TLDSJPWORK/ESP32_CAN-FD_GWCombiBoard/hardware/production/README.md

# 製造データ

- [Gerber・ドリルデータ](ESP32_CAN-FD_GWCombiBoard.zip)
- [BOM](bom.csv)
- [部品情報](designators.csv)
- [部品配置](positions.csv)
- [ネットリスト](netlist.ipc)

再製造する場合は、使用する部品・実装内容に合わせてデータを確認してください。

BOMのU1はValue・Footprintが空欄です。部品実装を発注する場合は、使用するESP32開発ボードに合わせて補ってください。
