TLDSJPWORK/ESP32_CAN-FD_GWCombiBoard/hardware/production/bom.csv

Designator | Footprint | Quantity | Value | LCSC Part #
DB1 | DB9-TH_LD09P33E4GV00LF | 1 | XDDB-1809-0816 | C7498157
J1, J5 | PinSocket_1x19_P2.54mm_Vertical | 2 | Conn_01x19_Pin
J10, J9 | PinSocket_1x08_P2.54mm_Vertical | 2 | Conn_01x08_Socket
J2 | PinSocket_1x16_P2.54mm_Vertical | 1 | Conn_01x16_Pin
J3, J4 | PinSocket_1x03_P2.54mm_Vertical | 2 | Conn_01x03_Socket
J6 | JST_XH_B4B-XH-AM_1x04_P2.50mm_Vertical | 1 | Conn_01x04
J7 | PinSocket_1x03_P2.54mm_Vertical | 1 | Conn_01x03_Pin
J8 | TerminalBlock_RND_205-00012_1x02_P5.00mm_Horizontal | 1 | Screw_Terminal_01x02
U1 |  | 1
