TLDSJPWORK/ESP32_CAN-FD_GWCombiBoard/mechanical/ESP32_CAN-FD_GWCombiBoard-下筐体.stl

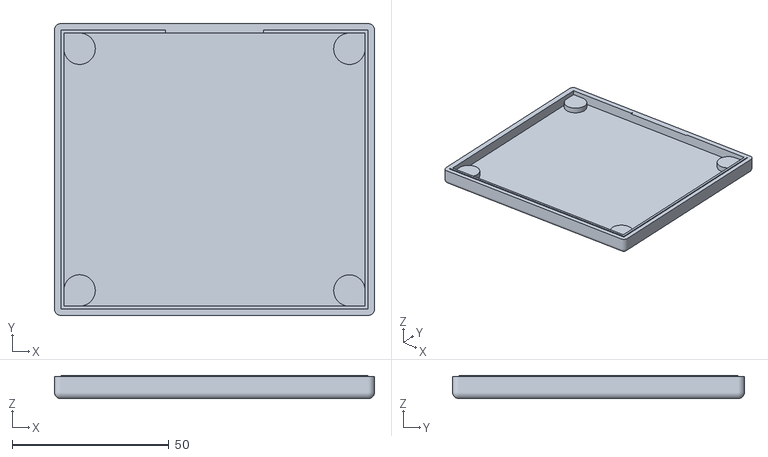
[picture p7: CAD file, 2026-10-12]
mechanical/ESP32_CAN-FD_GWCombiBoard-下筐体.stl
102.0 x 93.0 x 7.40
