TLDSJPWORK/ESP32_CAN-FD_GWCombiBoard/mechanical/ESP32_CAN-FD_GWCombiBoard.step

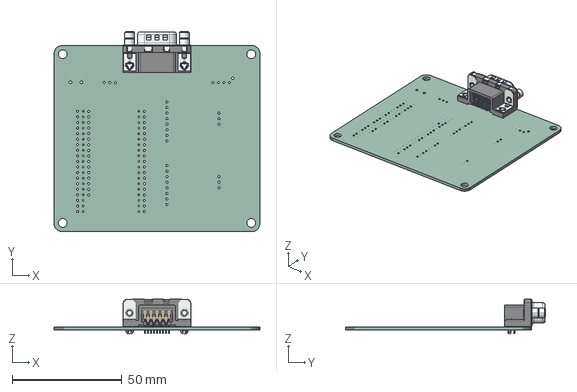
[picture p8: CAD file, 2026-10-12]
mechanical/ESP32_CAN-FD_GWCombiBoard.step
94.0 x 91.4 x 15.8 mm
DB9-TH_LD09P33E4GV00LF
ESP32_CAN-FD_GWCombiBoard_PCB
