TLDSJPWORK/ESP32_CAN-FD_GWCombiBoard/docs/schematic.pdf

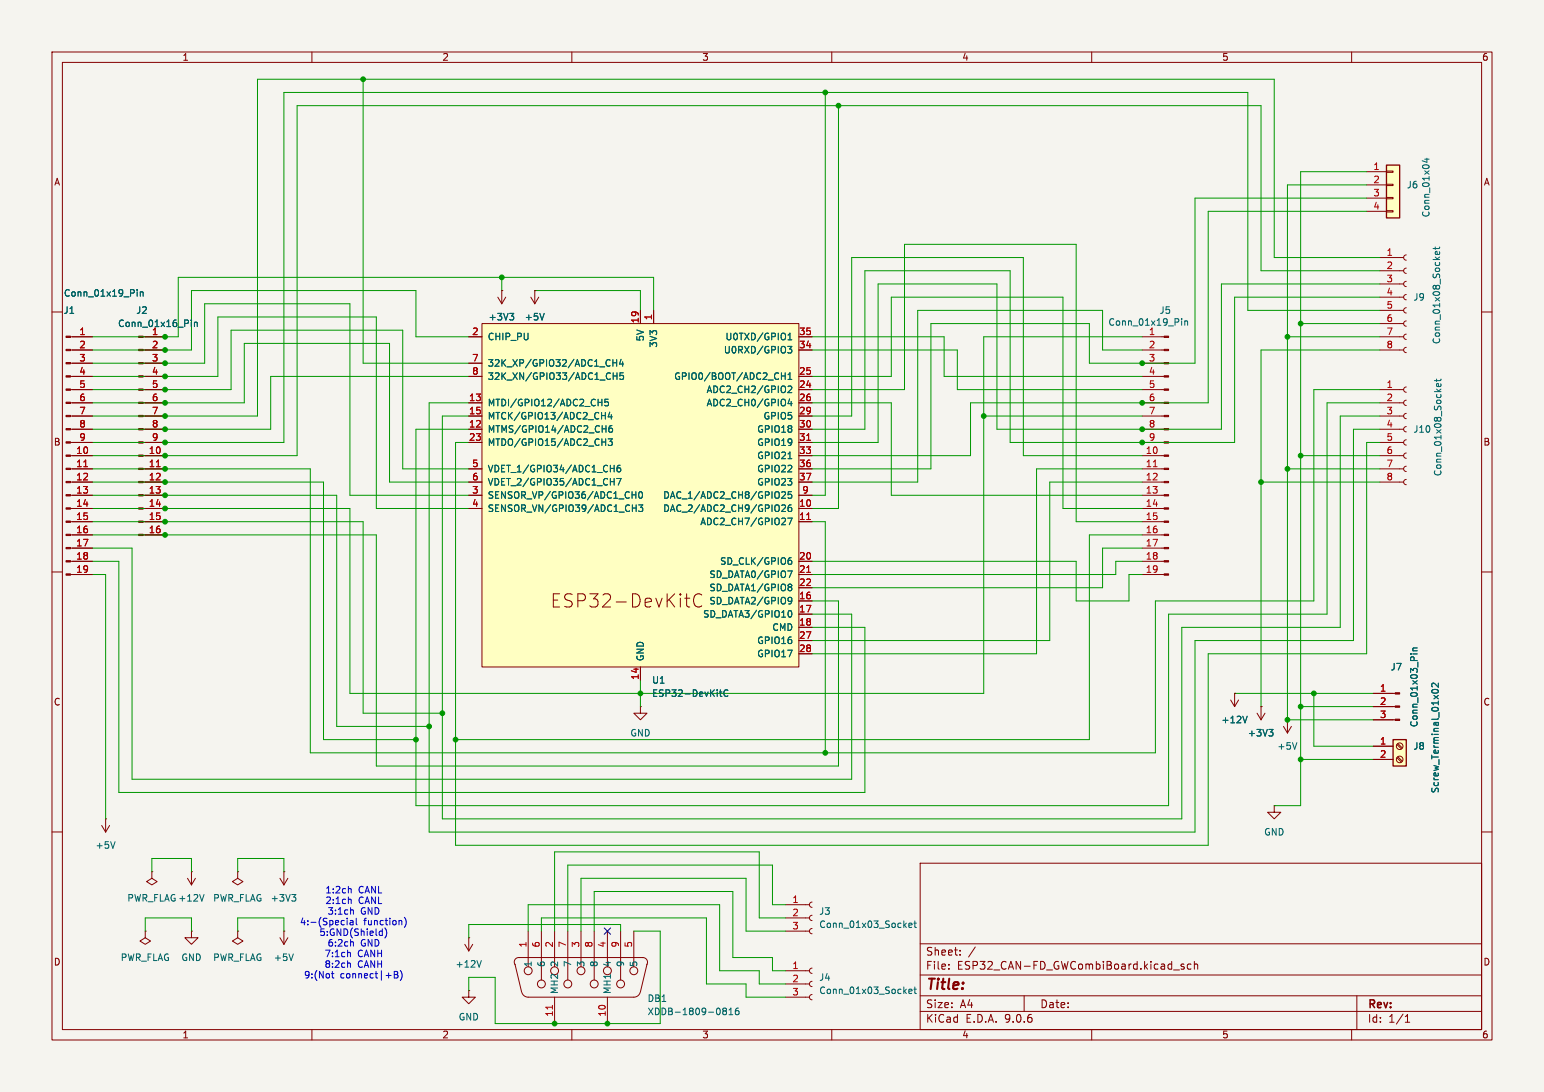
[picture p9: page 1]
