TLDSJPWORK/ESP32_CAN-FD_GWCombiBoard/hardware/kicad/ESP32_CAN-FD_GWCombiBoard.kicad_pcb

## KiCad design hardware/kicad/ESP32_CAN-FD_GWCombiBoard.kicad_pcb (2026-10-12)

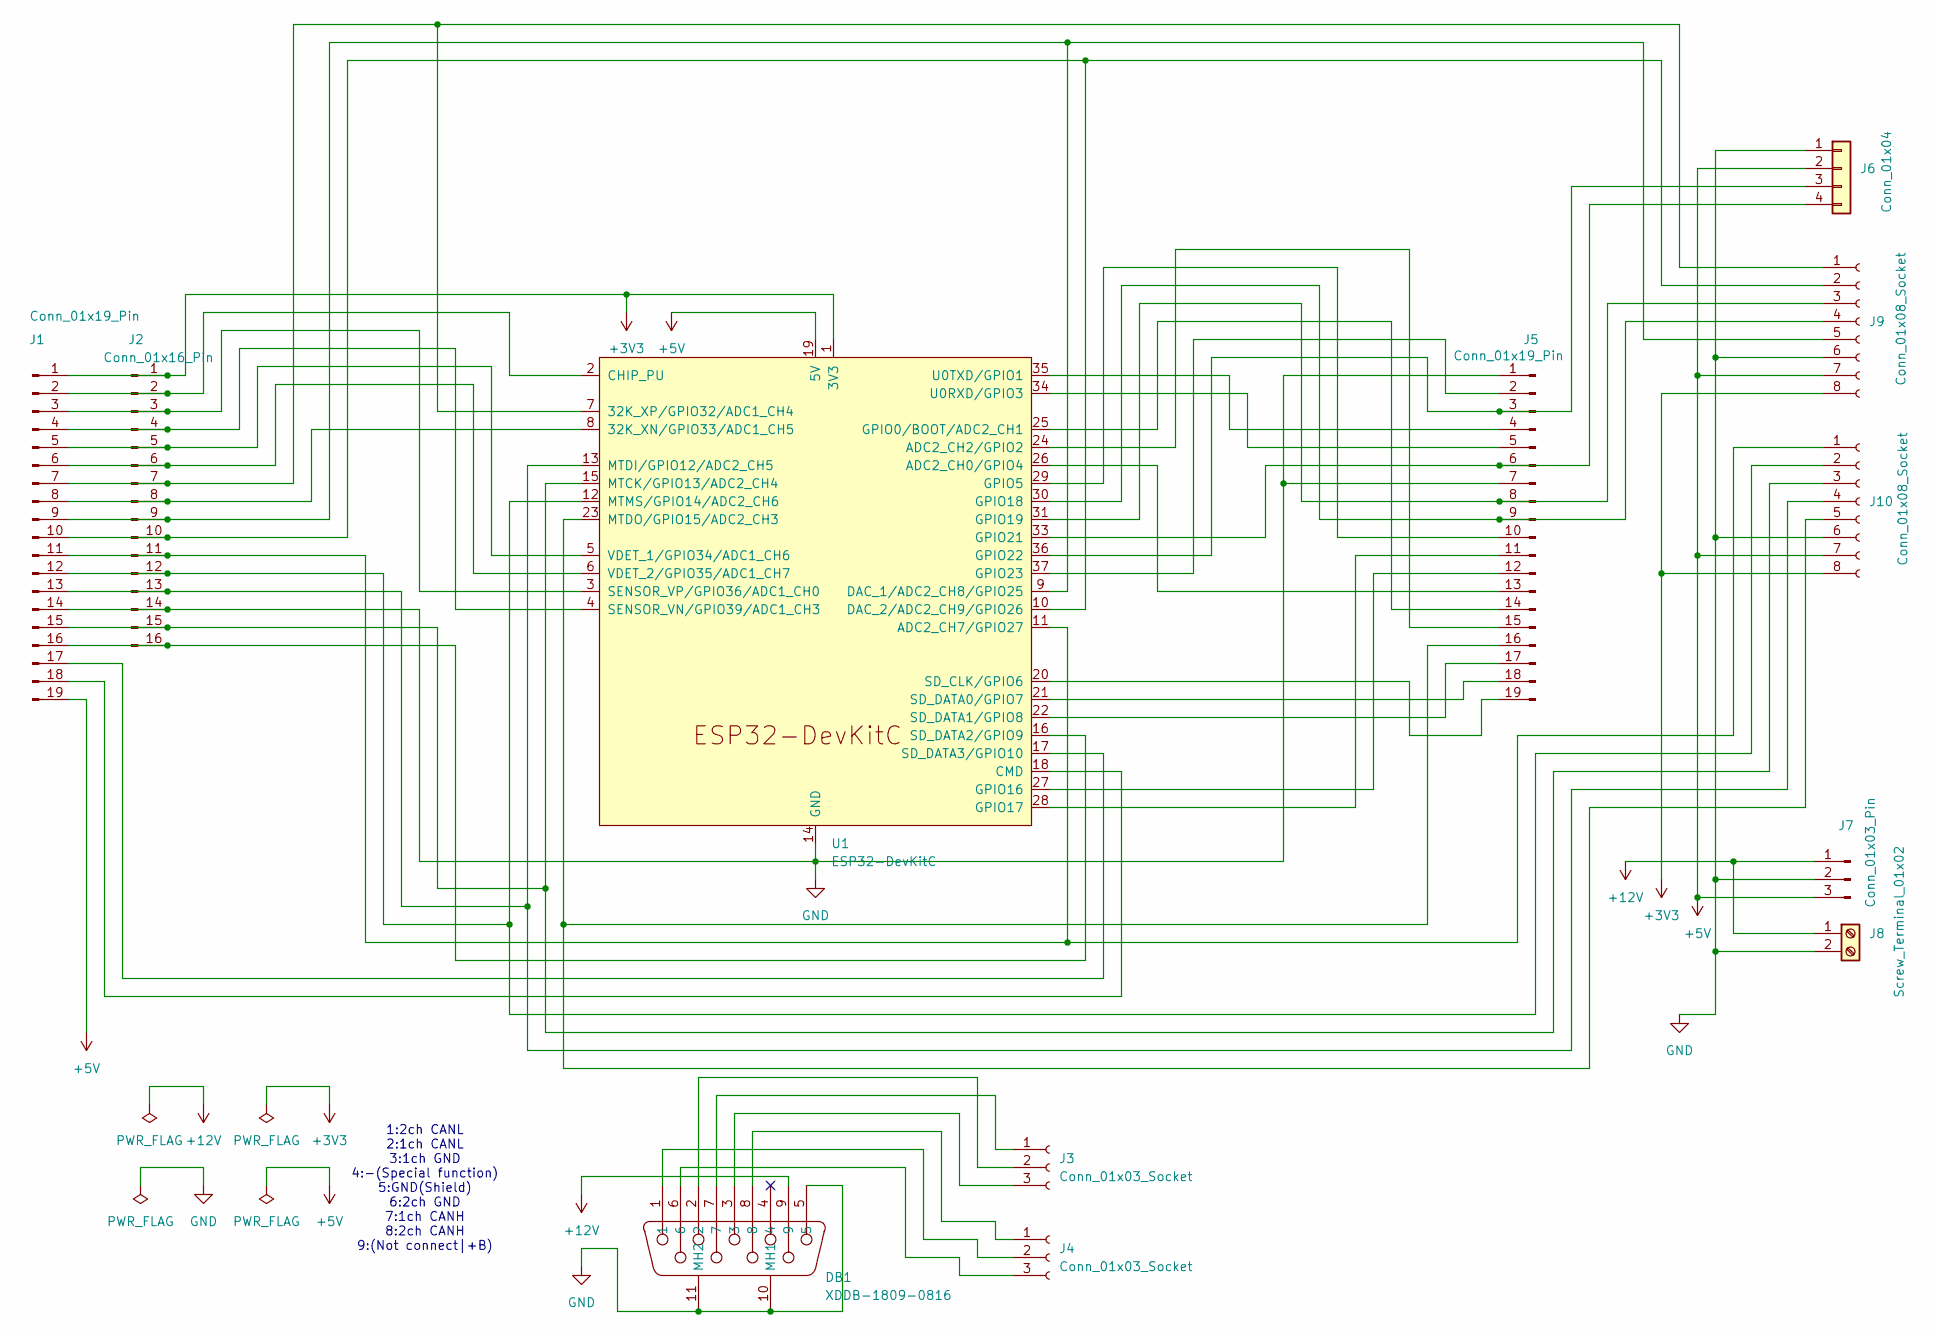
[picture p10: schematic ESP32_CAN-FD_GWCombiBoard.kicad_sch]

Parts:
DB1: XDDB-1809-0816; DB9-TH_LD09P33E4GV00LF; LCSC Part C7498157
J1, J5: Conn_01x19_Pin; PinSocket_1x19_P2.54mm_Vertical
J2: Conn_01x16_Pin; PinSocket_1x16_P2.54mm_Vertical
J3, J4: Conn_01x03_Socket; PinSocket_1x03_P2.54mm_Vertical
J6: Conn_01x04; JST_XH_B4B-XH-AM_1x04_P2.50mm_Vertical
J7: Conn_01x03_Pin; PinSocket_1x03_P2.54mm_Vertical
J8: Screw_Terminal_01x02; TerminalBlock_RND_205-00012_1x02_P5.00mm_Horizontal
J9, J10: Conn_01x08_Socket; PinSocket_1x08_P2.54mm_Vertical
U1: ESP32-DevKitC

Connections:
+3V3: J1.1, J2.1, J9.8, J10.8, U1.1 (3V3)
+5V: J1.19, J6.2, J7.3, J9.7, J10.7, U1.19 (5V)
+12V: DB1.9, J7.1, J8.1
GND: DB1.5, DB1.10 (MH1), DB1.11 (MH2), J1.14, J2.14, J5.1, J5.7, J6.1, J7.2, J8.2, J9.6, J10.6, U1.14 (GND), U1.32 (GND), U1.38 (GND)
unnamed: J1.2, J2.2, U1.2 (CHIP_PU)
unnamed: J1.3, J2.3, U1.3 (SENSOR_VP/GPIO36/ADC1_CH0)
unnamed: J1.4, J2.4, U1.4 (SENSOR_VN/GPIO39/ADC1_CH3)
unnamed: J1.5, J2.5, U1.5 (VDET_1/GPIO34/ADC1_CH6)
unnamed: J1.6, J2.6, U1.6 (VDET_2/GPIO35/ADC1_CH7)
unnamed: J1.7, J2.7, J9.1, U1.7 (32K_XP/GPIO32/ADC1_CH4)
unnamed: J1.8, J2.8, U1.8 (32K_XN/GPIO33/ADC1_CH5)
unnamed: J1.9, J2.9, J9.5, U1.9 (DAC_1/ADC2_CH8/GPIO25)
unnamed: J1.10, J2.10, J9.2, U1.10 (DAC_2/ADC2_CH9/GPIO26)
unnamed: J1.11, J2.11, J10.1, U1.11 (ADC2_CH7/GPIO27)
unnamed: J1.12, J2.12, J10.2, U1.12 (MTMS/GPIO14/ADC2_CH6)
unnamed: J1.13, J2.13, J10.4, U1.13 (MTDI/GPIO12/ADC2_CH5)
unnamed: J1.15, J2.15, J10.3, U1.15 (MTCK/GPIO13/ADC2_CH4)
unnamed: J1.16, J2.16, U1.16 (SD_DATA2/GPIO9)
unnamed: J1.17, U1.17 (SD_DATA3/GPIO10)
unnamed: J1.18, U1.18 (CMD)
unnamed: DB1.7, J3.1
unnamed: DB1.2, J3.2
unnamed: DB1.3, J3.3
unnamed: DB1.8, J4.1
unnamed: DB1.1, J4.2
unnamed: DB1.6, J4.3
unnamed: J5.2, U1.37 (GPIO23)
unnamed: J5.3, J6.3, U1.36 (GPIO22)
unnamed: J5.4, U1.35 (U0TXD/GPIO1)
unnamed: J5.5, U1.34 (U0RXD/GPIO3)
unnamed: J5.6, J6.4, U1.33 (GPIO21)
unnamed: J5.8, J9.3, U1.31 (GPIO19)
unnamed: J5.9, J9.4, U1.30 (GPIO18)
unnamed: J5.10, U1.29 (GPIO5)
unnamed: J5.11, U1.28 (GPIO17)
unnamed: J5.12, U1.27 (GPIO16)
unnamed: J5.13, U1.26 (ADC2_CH0/GPIO4)
unnamed: J5.14, U1.25 (GPIO0/BOOT/ADC2_CH1)
unnamed: J5.15, U1.24 (ADC2_CH2/GPIO2)
unnamed: J5.17, U1.22 (SD_DATA1/GPIO8)
unnamed: J5.18, U1.21 (SD_DATA0/GPIO7)
unnamed: J5.19, U1.20 (SD_CLK/GPIO6)
unnamed: J5.16, J10.5, U1.23 (MTDO/GPIO15/ADC2_CH3)

Notes on the sheet:
1:2ch CANL 2:1ch CANL 3:1ch GND 4:-(Special function) 5:GND(Shield) 6:2ch GND 7:1ch CANH 8:2ch CANH 9:(Not connect|+B)

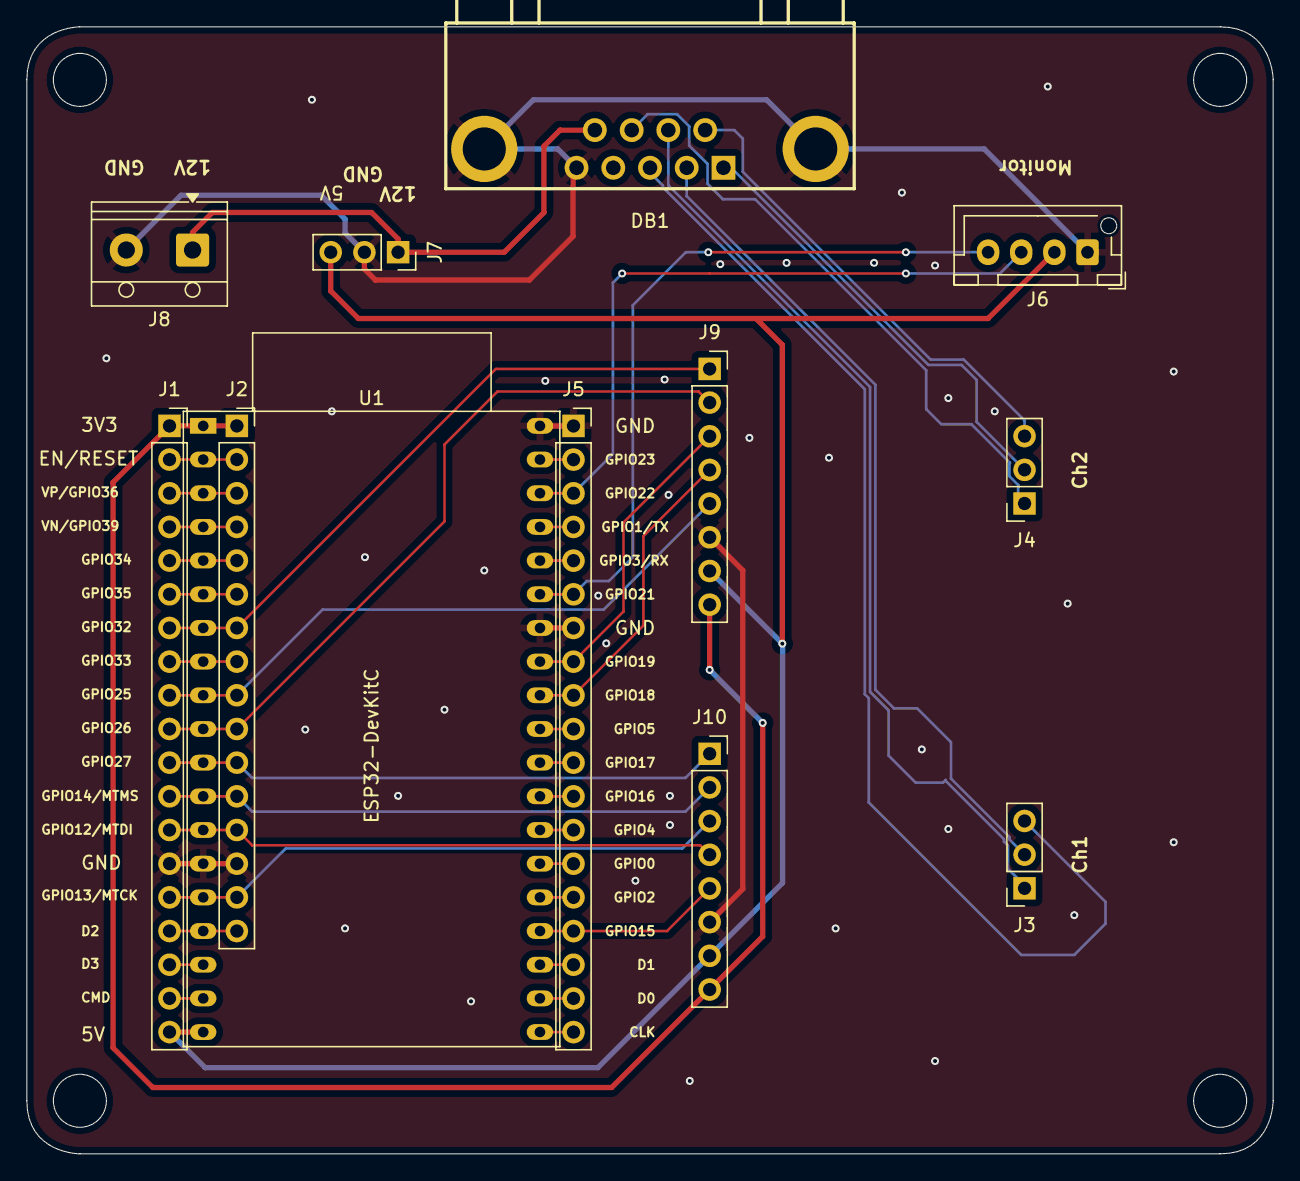
[picture p11: board ESP32_CAN-FD_GWCombiBoard.kicad_pcb from above]

Board: 2 copper layers, 94.0 x 85.0 mm, 12 parts (0 on the bottom side), 43 nets.
