TLDSJPWORK/ESP32_CAN-FD_GWCombiBoard/(commit log)

2026-10-12 Initial public hardware documentation and design files
    [ESP32_CAN-FD_GWCombiBoard-上筐体.stl, ESP32_CAN-FD_GWCombiBoard-下筐体.stl, ESP32_CAN-FD_GWCombiBoard.kicad_pcb, ESP32_CAN-FD_GWCombiBoard.kicad_sch, ESP32_CAN-FD_GWCombiBoard.step, bom.csv, designators.csv, positions.csv]
2026-10-13 Clarify bare PCB inspection versus assembled example validation
2026-10-13 Present confirmed design specifications and current publication status
2026-10-15 docs: update publication draft and simplify public materials
2026-10-15 docs: link published MakerWorld enclosure
2026-10-18 Fix CAN module GPIO mapping and add tested bidirectional gateway example
    [PassThroughGateway.ino]
2026-10-18 Verify final gateway frames without guard traffic and document peer IRQ fix
    [test_socketcan_gateway.py]
2026-10-18 docs: align product descriptions with tested gateway sample
